julienp17/WaveMirror/arduino/README.md

The **waveMirror** directory contains the program used for the project.

The **examples** directory only contains parts of the code, to test standalone features (I2C, a Servo-motor, etc...).
