julienp17/WaveMirror/presentation/elements/pictures/fritzing/arduino_fritzing.png

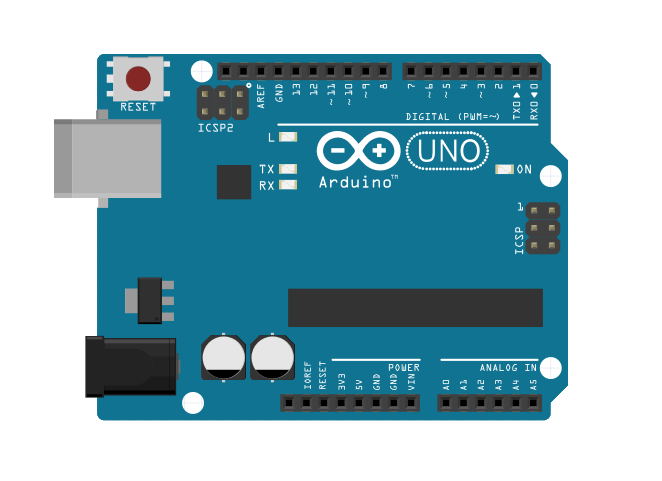
presentation/elements/pictures/fritzing/arduino_fritzing.png
