julienp17/WaveMirror/presentation/elements/pictures/hqdefault.jpg

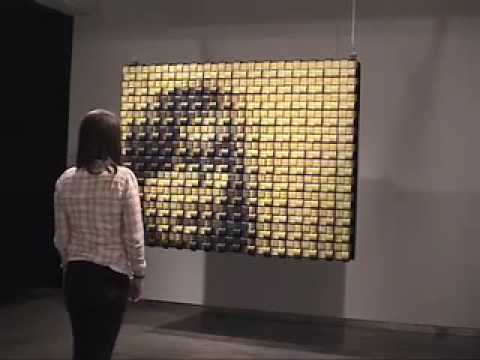
presentation/elements/pictures/hqdefault.jpg
