julienp17/WaveMirror/presentation/elements/pictures/weave-mirror.jpg

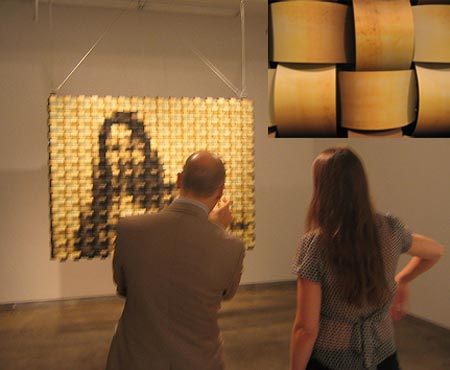
presentation/elements/pictures/weave-mirror.jpg
