julienp17/WaveMirror/presentation/elements/pictures/Weave-small_e.jpg

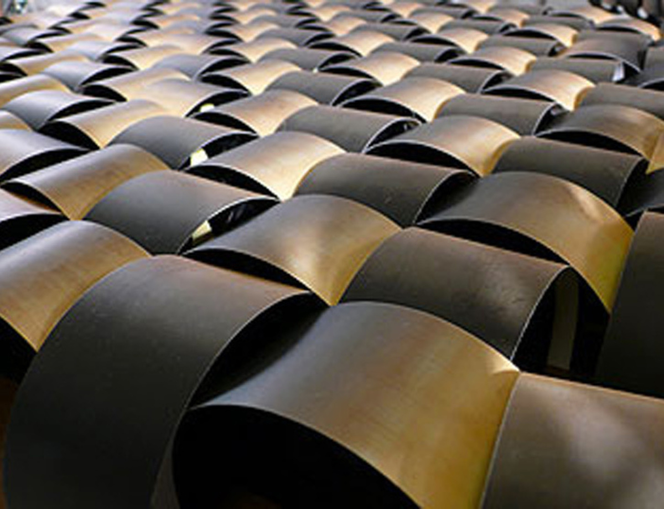
presentation/elements/pictures/Weave-small_e.jpg
