julienp17/WaveMirror/presentation/elements/pictures/weavemirror.jpg

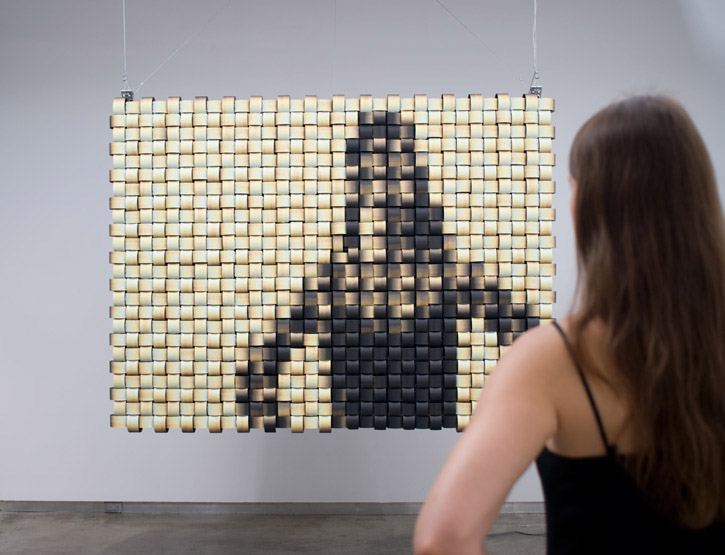
presentation/elements/pictures/weavemirror.jpg
