julienp17/WaveMirror/presentation/elements/pictures/weavemirrormov.jpg

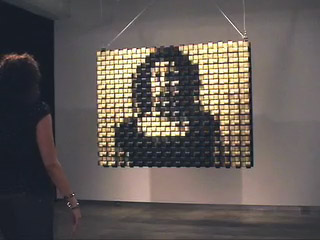
presentation/elements/pictures/weavemirrormov.jpg
