julienp17/WaveMirror/presentation/elements/raspberry_pi/colonne_X.png

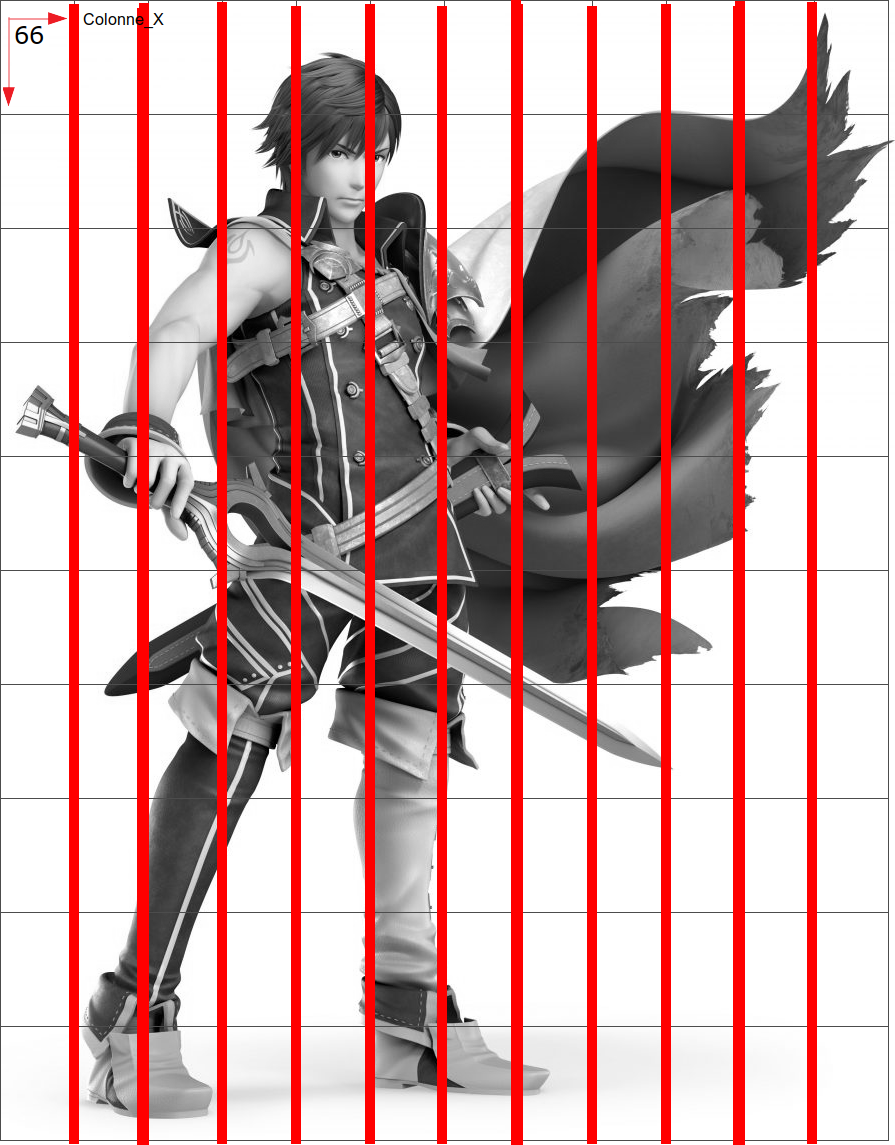
presentation/elements/raspberry_pi/colonne_X.png
