julienp17/WaveMirror/presentation/elements/raspberry_pi/first_line.png

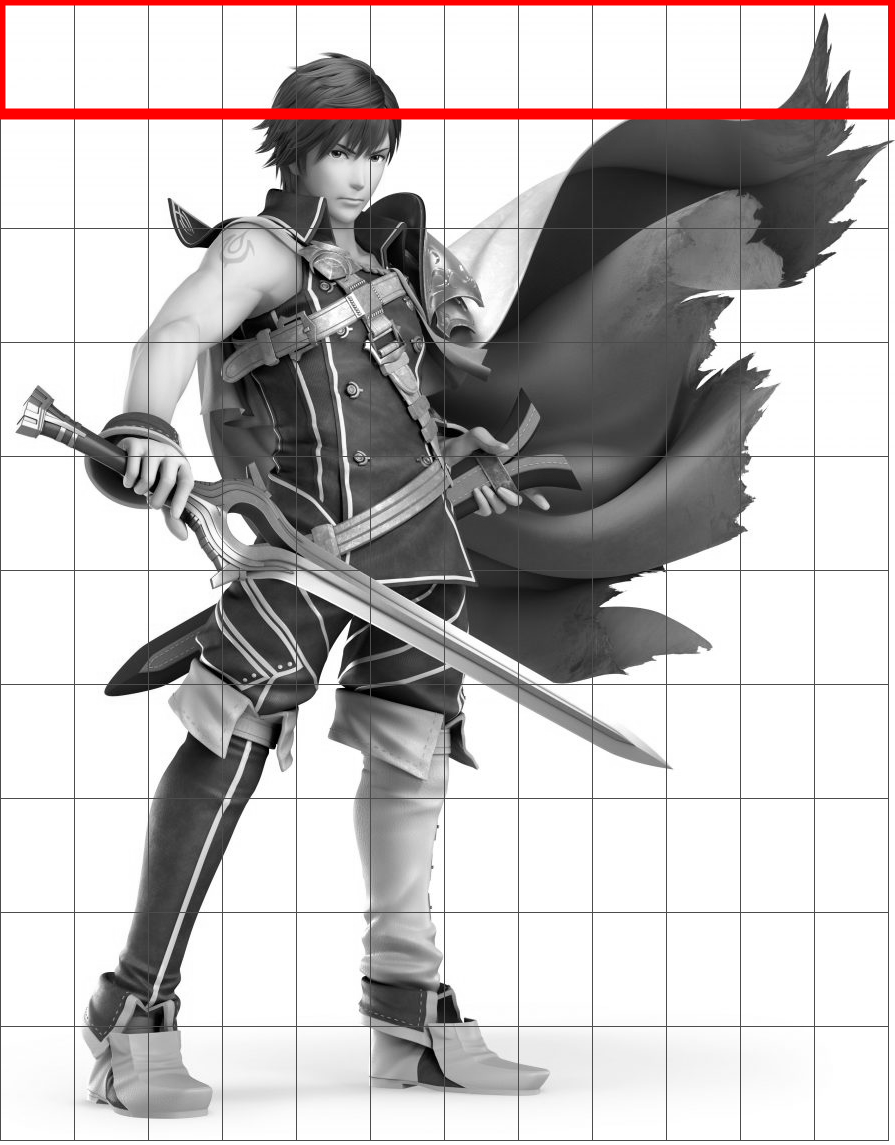
presentation/elements/raspberry_pi/first_line.png
