julienp17/WaveMirror/presentation/elements/raspberry_pi/picamera.png

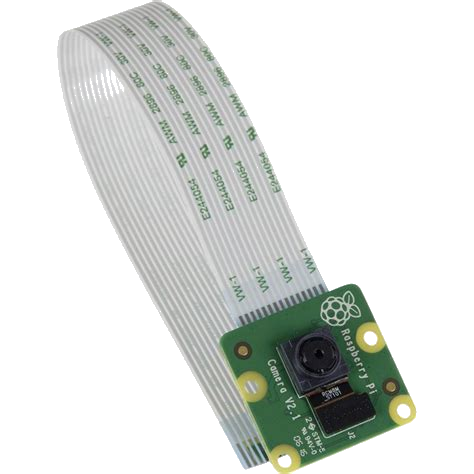
presentation/elements/raspberry_pi/picamera.png
