julienp17/WaveMirror/presentation/elements/raspberry_pi/pixel.png

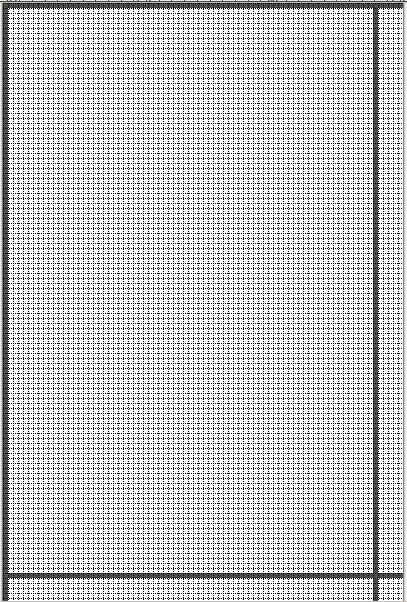
presentation/elements/raspberry_pi/pixel.png
