julienp17/WaveMirror/presentation/elements/raspberry_pi/pixel_dimensions.png

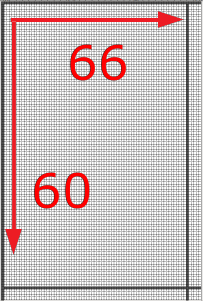
presentation/elements/raspberry_pi/pixel_dimensions.png
