julienp17/WaveMirror/presentation/elements/raspberry_pi/raspberryPi.png

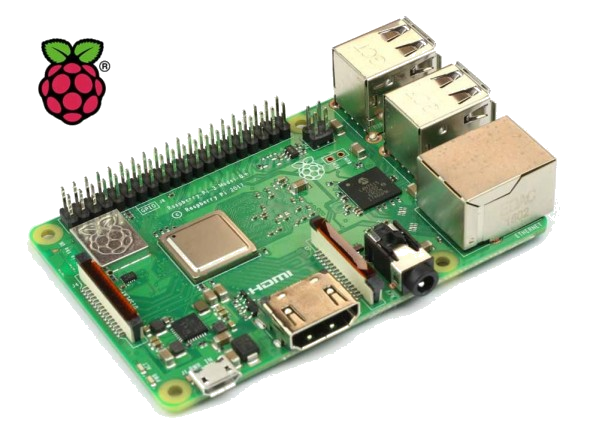
presentation/elements/raspberry_pi/raspberryPi.png
