julienp17/WaveMirror/presentation/elements/raspberry_pi/raspbian.png

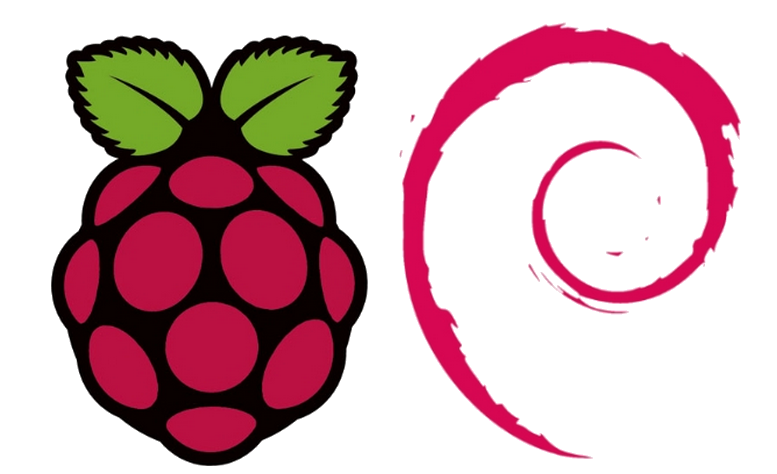
presentation/elements/raspberry_pi/raspbian.png
