julienp17/WaveMirror/presentation/elements/raspberry_pi/smiley2.png

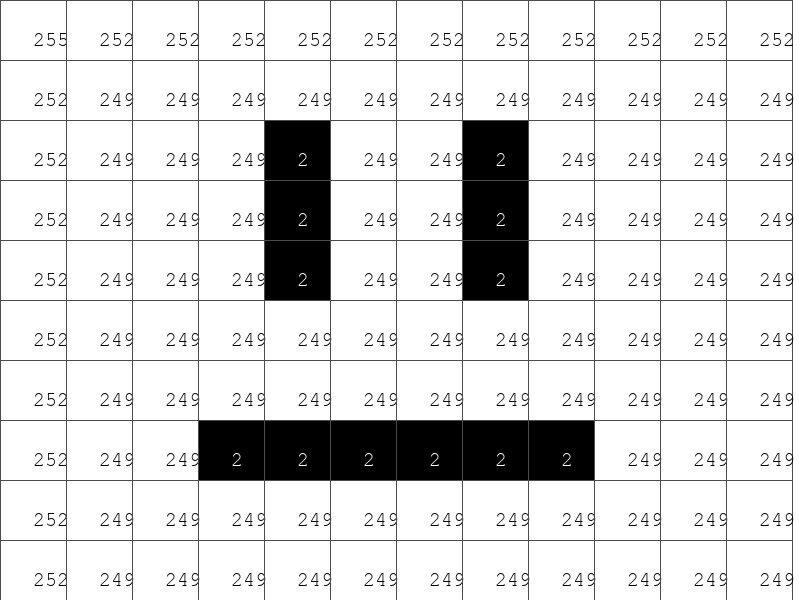
presentation/elements/raspberry_pi/smiley2.png
