julienp17/WaveMirror/presentation/elements/raspberry_pi/smiley3.png

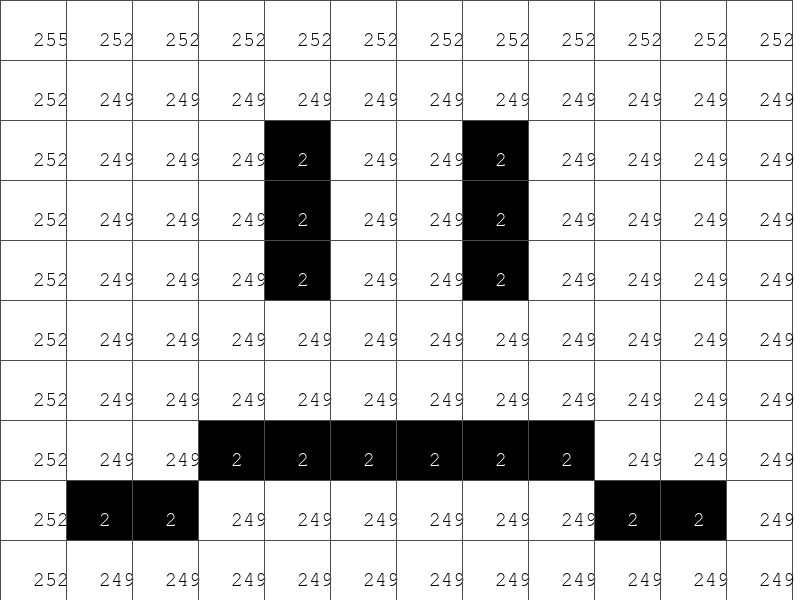
presentation/elements/raspberry_pi/smiley3.png
