julienp17/WaveMirror/raspberry_pi/examples/pictures/chrom.png

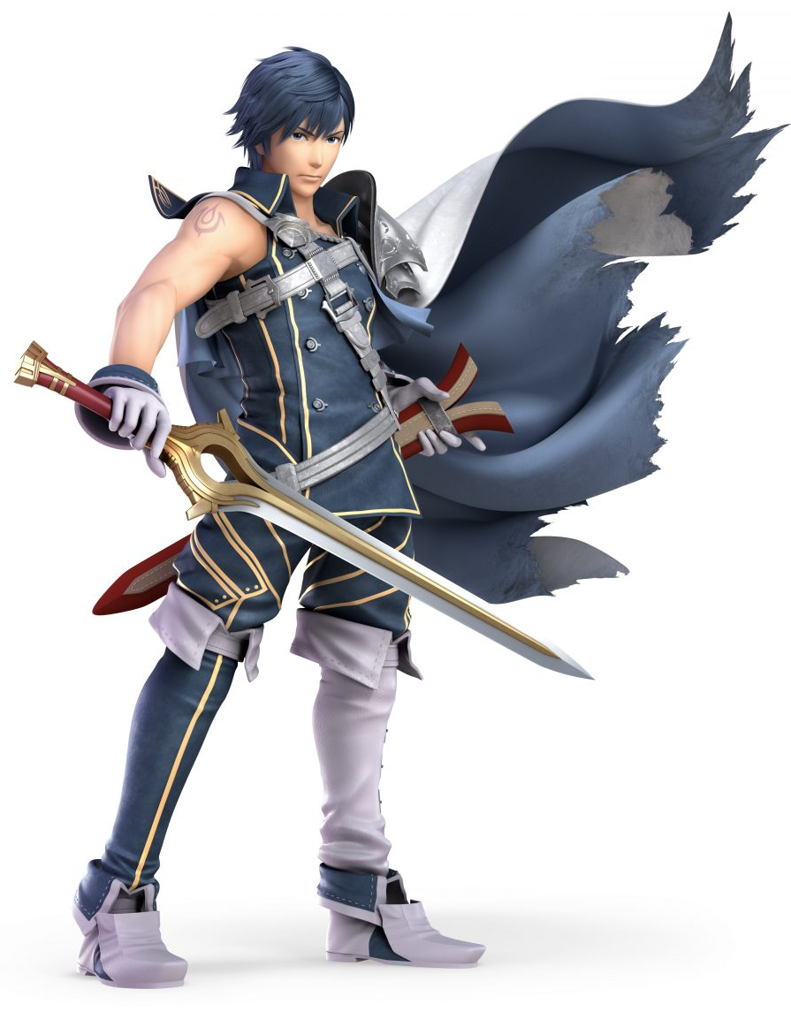
raspberry_pi/examples/pictures/chrom.png
