julienp17/WaveMirror/raspberry_pi/examples/pictures/grid.png

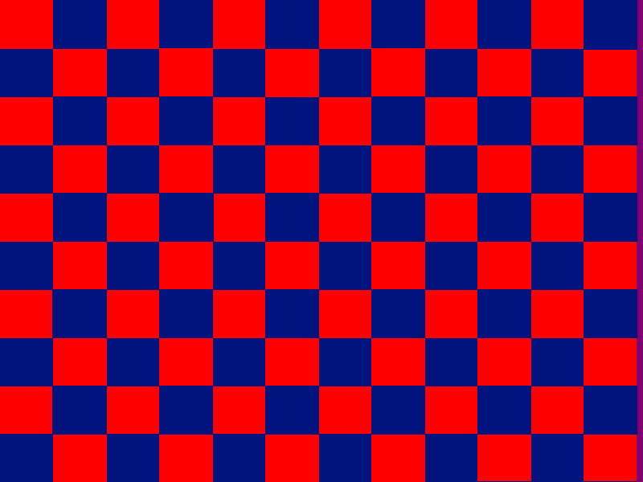
raspberry_pi/examples/pictures/grid.png
