julienp17/WaveMirror/raspberry_pi/examples/pictures/O.png

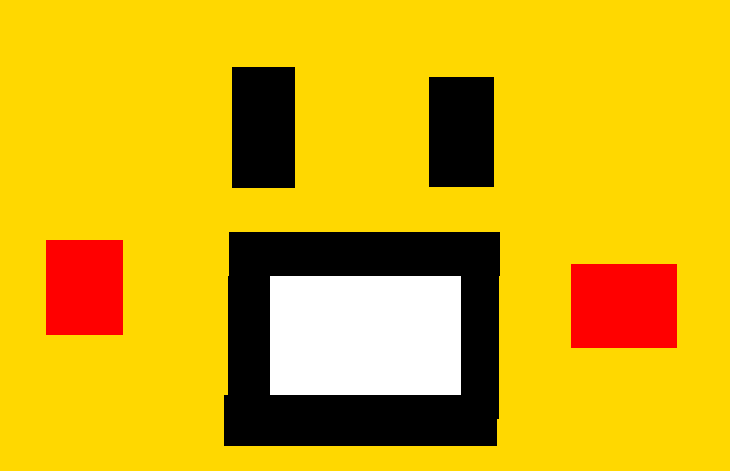
raspberry_pi/examples/pictures/O.png
