julienp17/WaveMirror/raspberry_pi/examples/pictures/smileyHappy.png

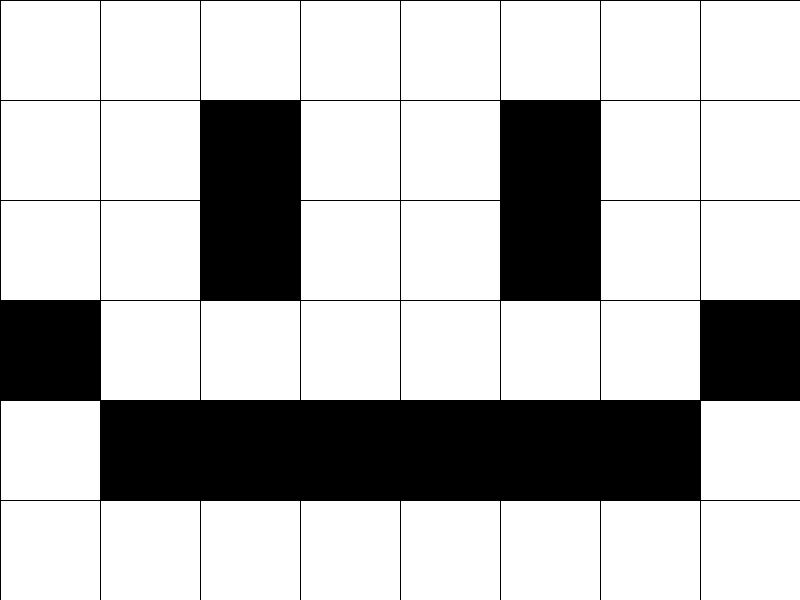
raspberry_pi/examples/pictures/smileyHappy.png
