julienp17/WaveMirror/raspberry_pi/examples/pictures/smileyNeutral.png

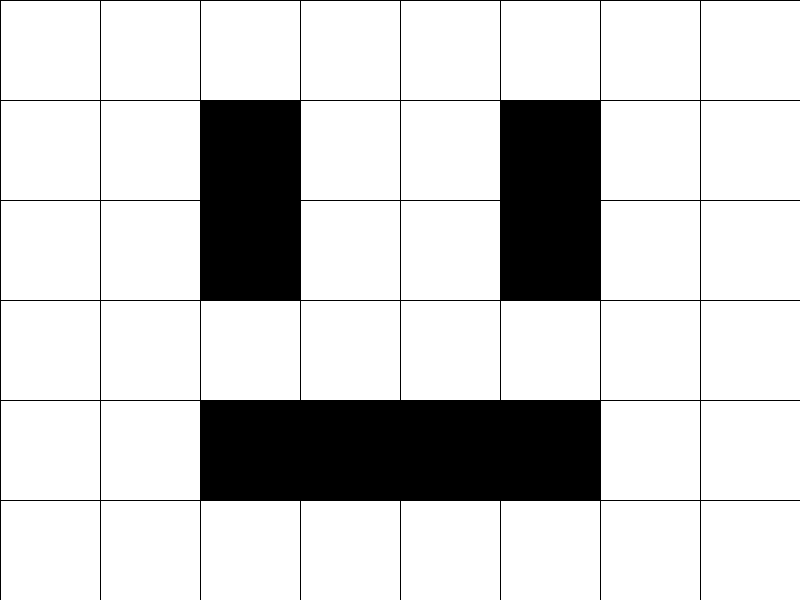
raspberry_pi/examples/pictures/smileyNeutral.png
