julienp17/WaveMirror/raspberry_pi/examples/pictures/smileySad.png

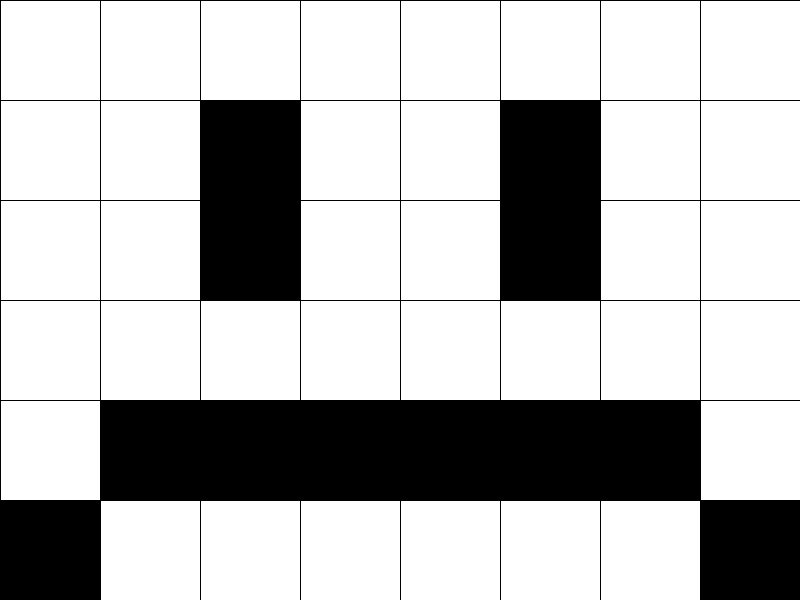
raspberry_pi/examples/pictures/smileySad.png
