julienp17/WaveMirror/solidworks/pieces/mini-servo-9g/Renderings/Mini_servo.JPG

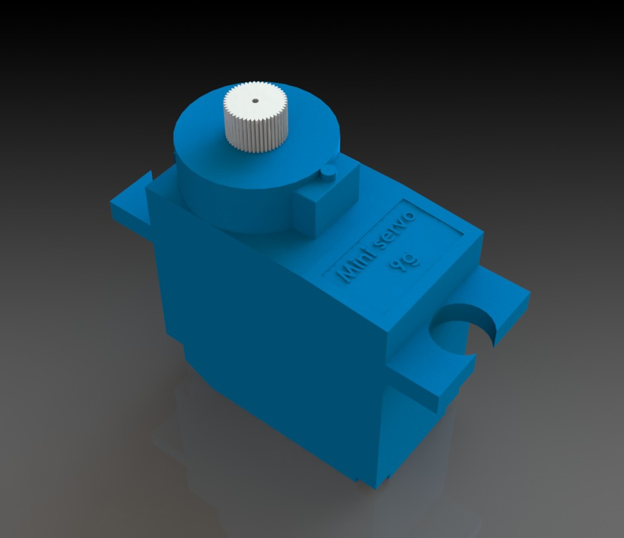
solidworks/pieces/mini-servo-9g/Renderings/Mini_servo.JPG
