julienp17/WaveMirror/solidworks/pieces/servo hs-55/Servo Hitec HS-55 .png

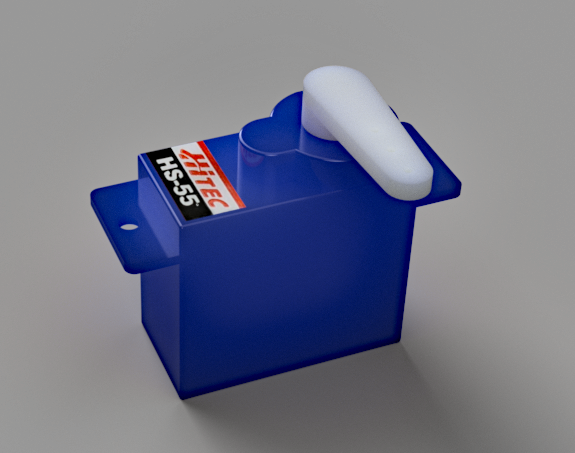
solidworks/pieces/servo hs-55/Servo Hitec HS-55 .png
