julienp17/WaveMirror/solidworks/assemblages/Assemblage3_20190204.SLDASM

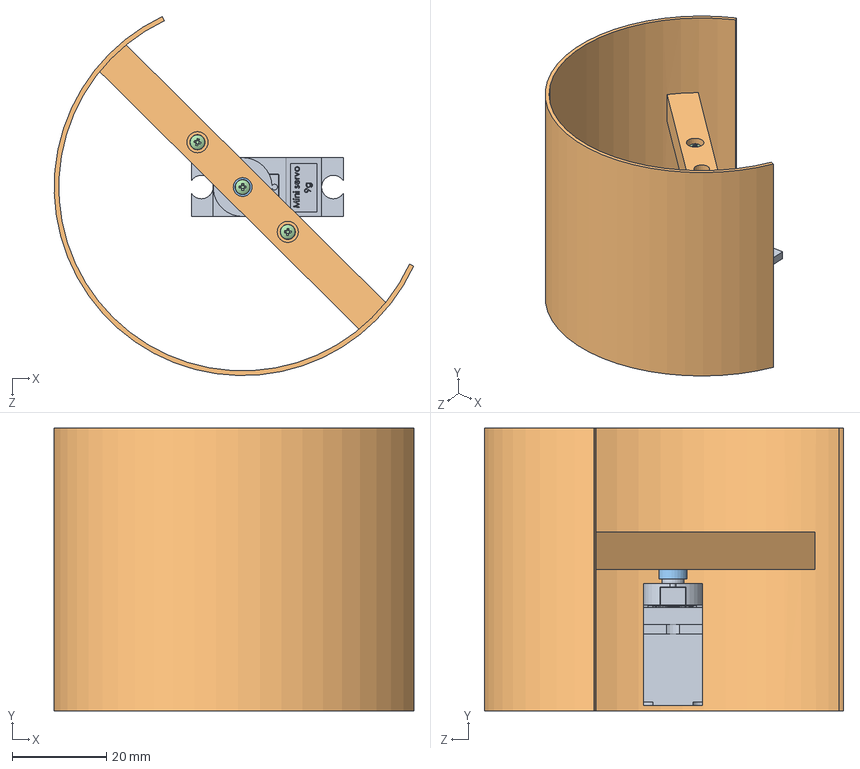
[picture p64: CAD file, 2019-03-29]
solidworks/assemblages/Assemblage3_20190204.SLDASM
76.3 x 60.0 x 76.2 mm
MiniServo
Cylindre4_20181203
palemoteur_20181029
pan head cross recess screw_isa x 3
