julienp17/WaveMirror/solidworks/pieces/mini-servo-9g/servomoteurhs-55_20181105.SLDASM

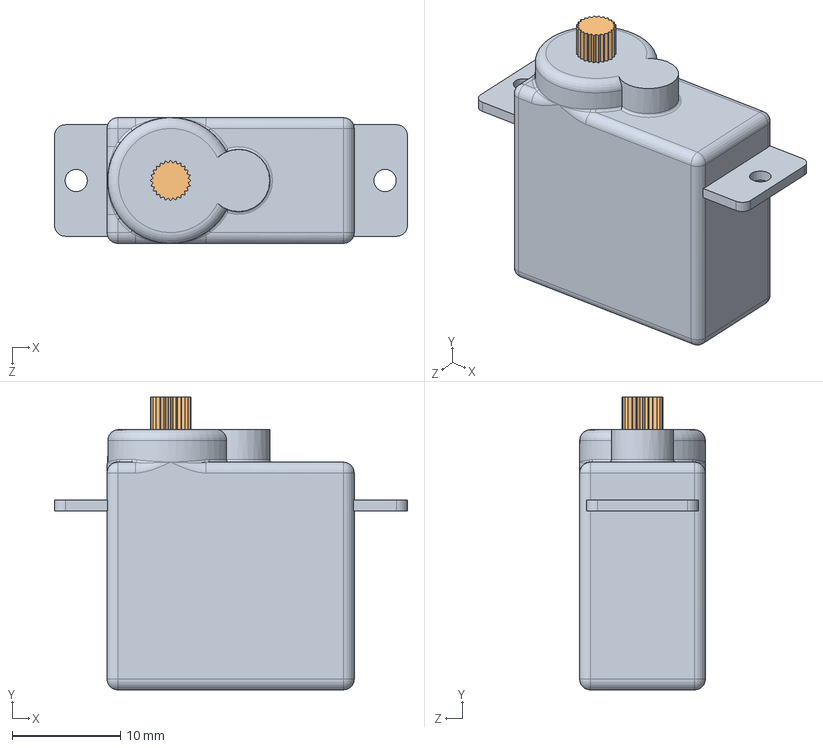
[picture p65: CAD file, 2018-11-21]
solidworks/pieces/mini-servo-9g/servomoteurhs-55_20181105.SLDASM
32.5 x 27.0 x 11.6 mm
Hi-Tec_HS-55_Bodyvrai
Hi-Tec_HS-55_Shaft
