julienp17/WaveMirror/solidworks/prototypes/Equipagemobile/Piece_entiere_20190215.SLDASM

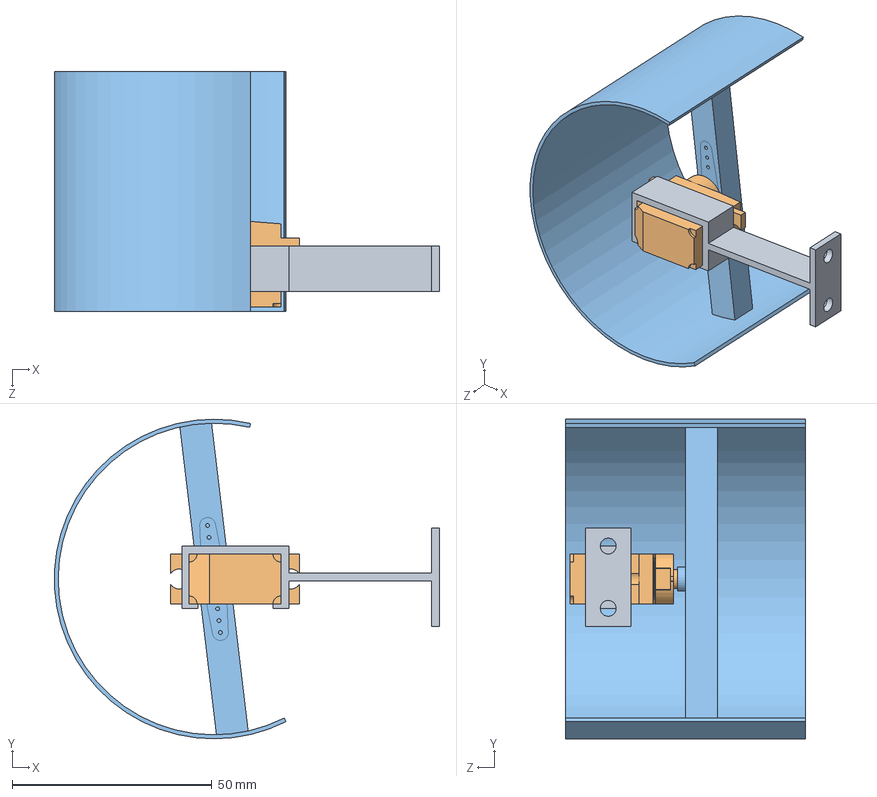
[picture p66: CAD file, 2019-03-29]
solidworks/prototypes/Equipagemobile/Piece_entiere_20190215.SLDASM
96.4 x 80.0 x 60.0 mm
supportmoteur2_20181210
MiniServo
Equipagemobile2_20190204
