julienp17/WaveMirror/solidworks/assemblages/Assemblage1_20180924.SLDASM

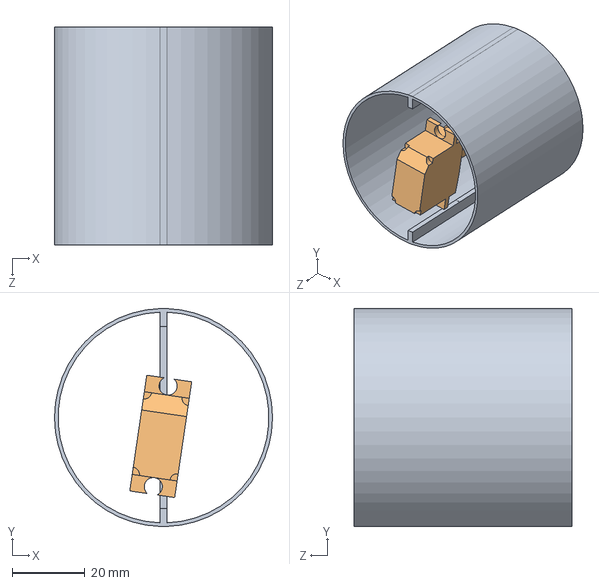
[picture p67: CAD file, 2018-11-21]
solidworks/assemblages/Assemblage1_20180924.SLDASM
60.0 x 60.0 x 60.0 mm
Prototype1_20180924
MiniServo
