julienp17/WaveMirror/solidworks/prototypes/Equipagemobile/Equipage_mobile3_20190211.SLDASM

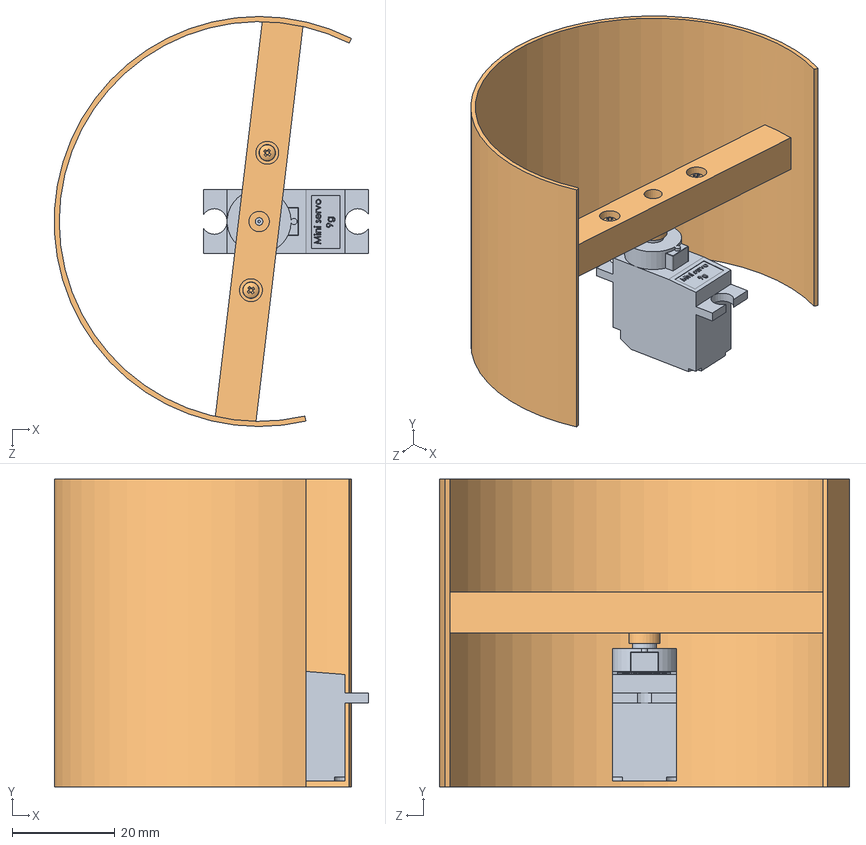
[picture p68: CAD file, 2019-03-29]
solidworks/prototypes/Equipagemobile/Equipage_mobile3_20190211.SLDASM
61.3 x 60.0 x 80.0 mm
MiniServo
Equipagemobile2_20190204
