julienp17/WaveMirror/solidworks/pieces/Cylindre_meca_3d_20190128.SLDASM

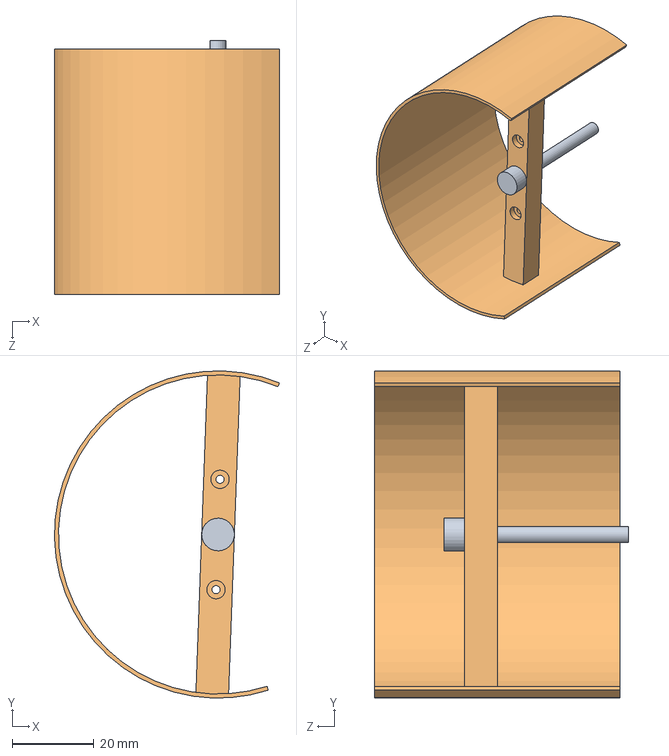
[picture p69: CAD file, 2019-03-29]
solidworks/pieces/Cylindre_meca_3d_20190128.SLDASM
55.0 x 79.9 x 62.0 mm
Pièce-pour_meca_3d
Cylindre4_20181203
