julienp17/WaveMirror/solidworks/pieces/palemoteur_20181029.SLDPRT

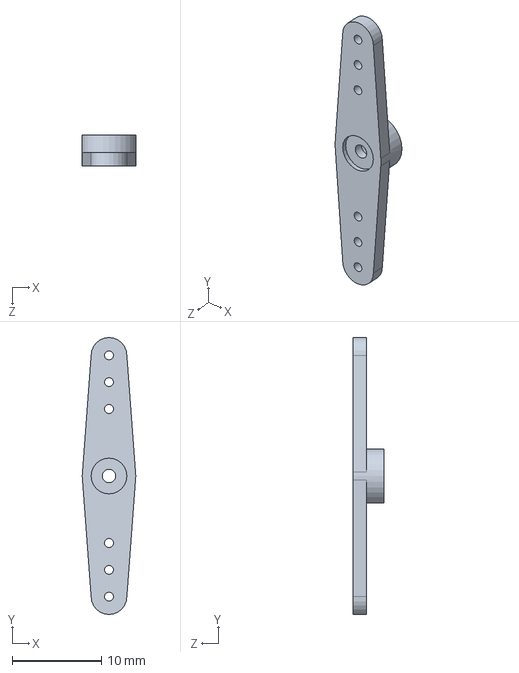
[picture p70: CAD file, 2019-03-29]
solidworks/pieces/palemoteur_20181029.SLDPRT
6.00 x 31.0 x 3.50 mm
