julienp17/WaveMirror/solidworks/prototypes/cylindres/Equipagemobile_20190204.SLDPRT

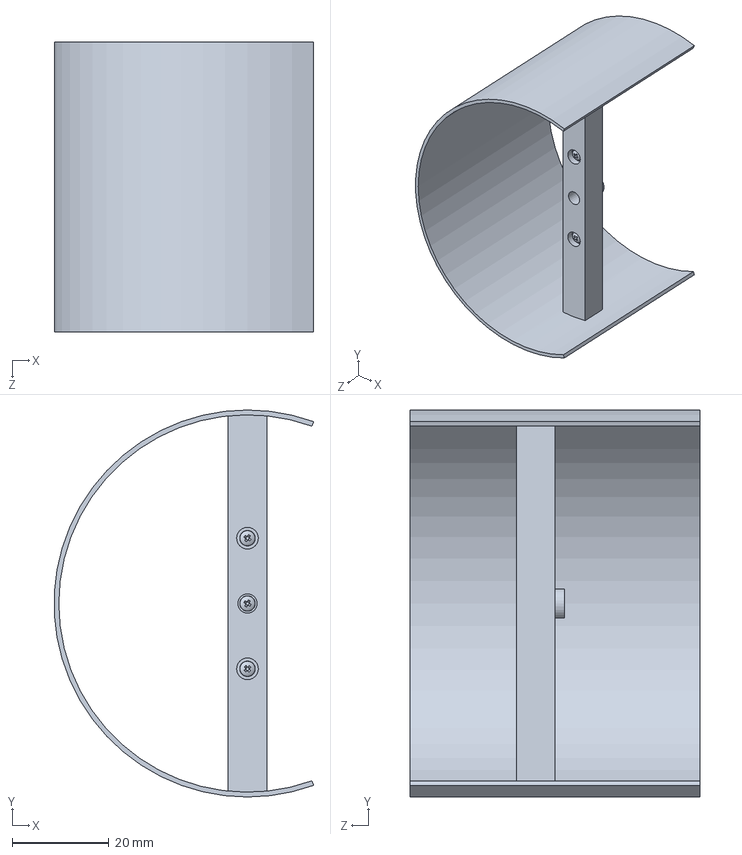
[picture p71: CAD file, 2019-03-29]
solidworks/prototypes/cylindres/Equipagemobile_20190204.SLDPRT
53.6 x 80.0 x 60.0 mm
