julienp17/WaveMirror/solidworks/prototypes/support_moteur/supportmoteur2_20181210.SLDPRT

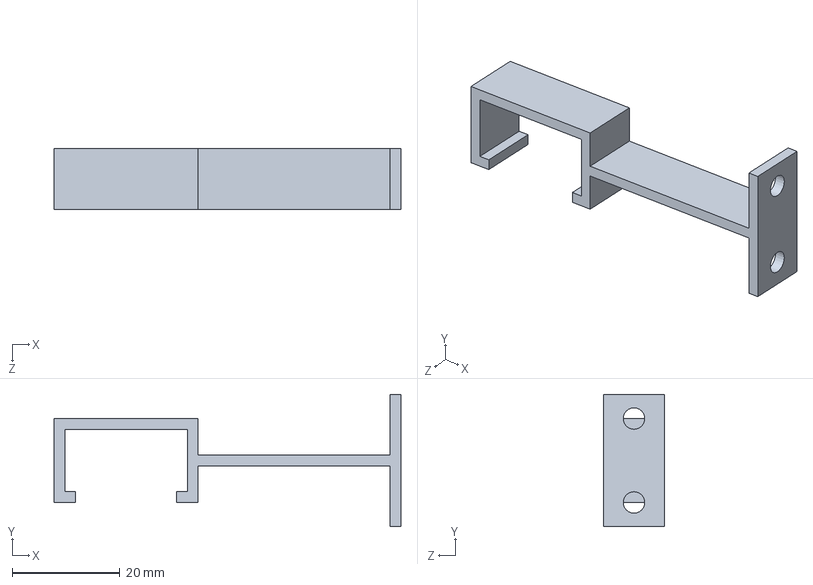
[picture p72: CAD file, 2019-03-29]
solidworks/prototypes/support_moteur/supportmoteur2_20181210.SLDPRT
64.5 x 24.6 x 11.3 mm
