julienp17/WaveMirror/solidworks/pieces/mini-servo-9g/MiniServo.SLDPRT

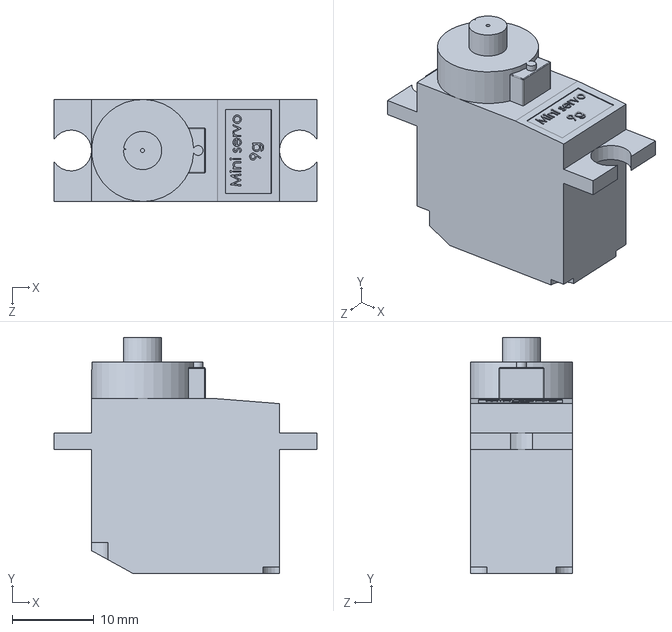
[picture p73: CAD file, 2018-11-21]
solidworks/pieces/mini-servo-9g/MiniServo.SLDPRT
32.2 x 28.9 x 12.5 mm
