julienp17/WaveMirror/solidworks/pieces/Piece-pour_meca_3d.SLDPRT

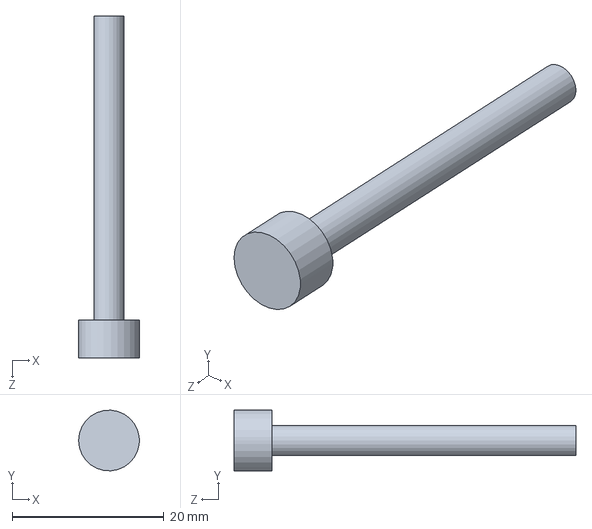
[picture p74: CAD file, 2019-03-29]
solidworks/pieces/Piece-pour_meca_3d.SLDPRT
8.00 x 7.99 x 45.0 mm
