julienp17/WaveMirror/solidworks/prototypes/support_moteur/supportmoteur1_20181210.SLDPRT

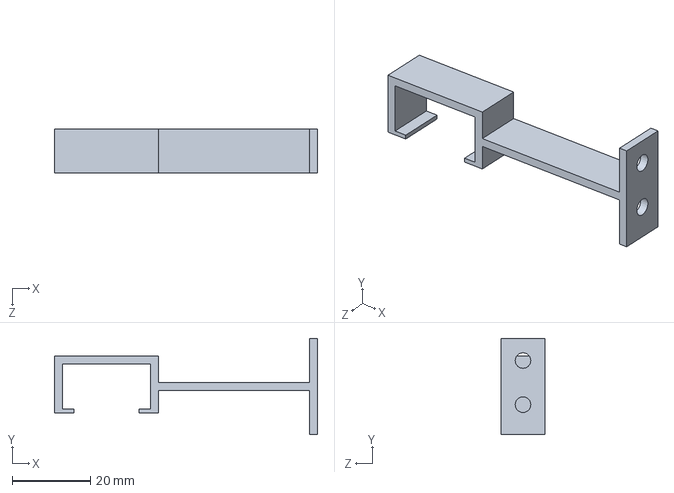
[picture p75: CAD file, 2018-12-14]
solidworks/prototypes/support_moteur/supportmoteur1_20181210.SLDPRT
67.3 x 24.6 x 11.3 mm
