julienp17/WaveMirror/solidworks/prototypes/cylindres/Cylindre4_20181203.SLDPRT

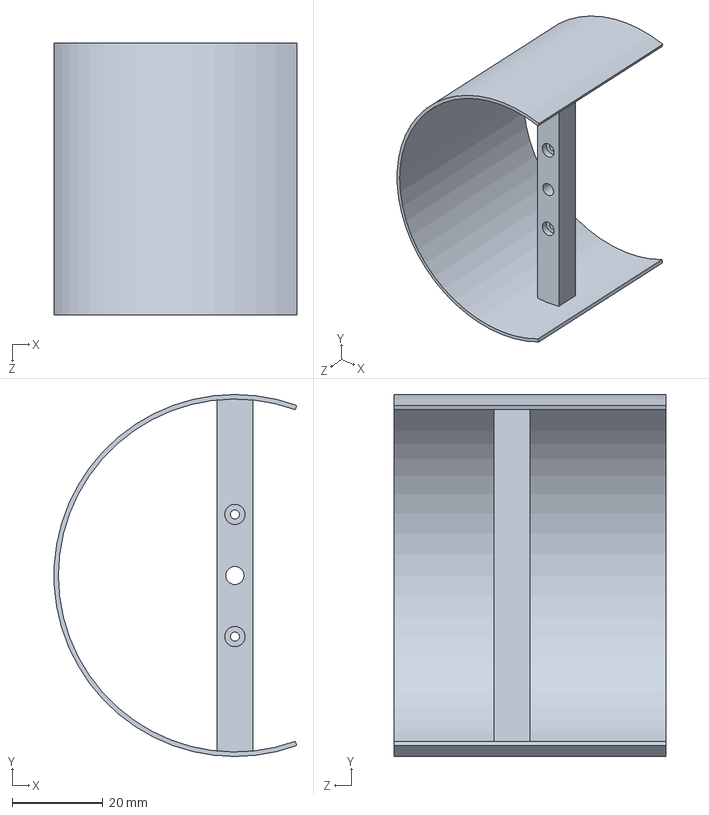
[picture p76: CAD file, 2019-03-29]
solidworks/prototypes/cylindres/Cylindre4_20181203.SLDPRT
53.6 x 80.0 x 60.0 mm
