julienp17/WaveMirror/solidworks/prototypes/support_moteur/supportmoteur1_20181203.SLDPRT

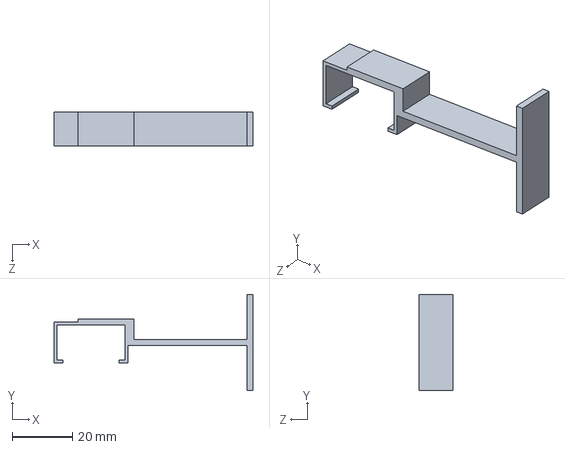
[picture p77: CAD file, 2018-12-14]
solidworks/prototypes/support_moteur/supportmoteur1_20181203.SLDPRT
66.3 x 32.0 x 11.3 mm
