julienp17/WaveMirror/solidworks/pieces/supportmoteur_20181008.SLDPRT

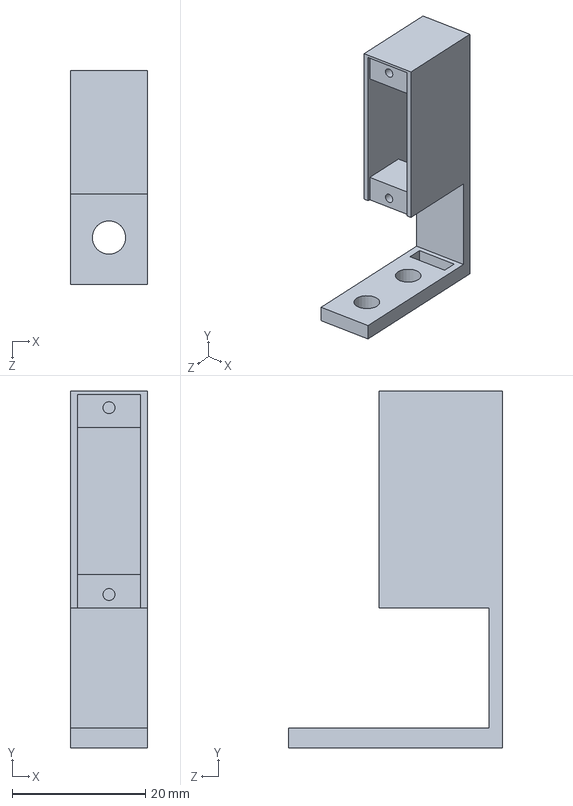
[picture p78: CAD file, 2018-11-21]
solidworks/pieces/supportmoteur_20181008.SLDPRT
11.5 x 53.5 x 32.0 mm
