julienp17/WaveMirror/solidworks/pieces/Cylindremoteursanspalme_20180917.SLDPRT

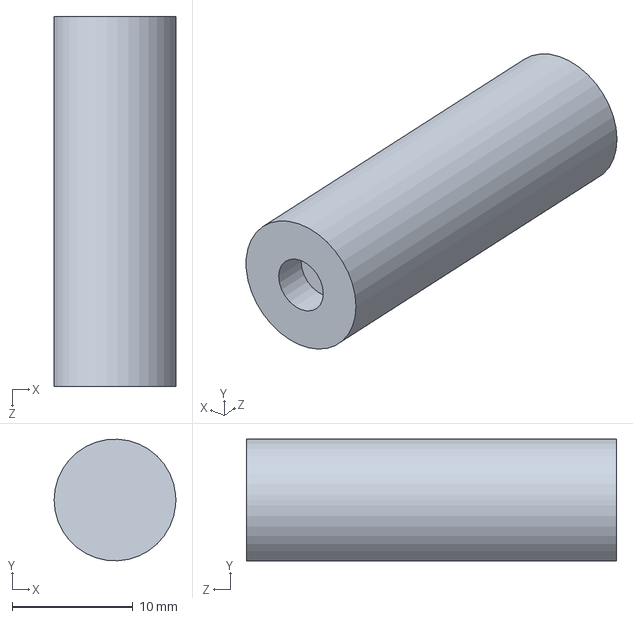
[picture p79: CAD file, 2018-11-21]
solidworks/pieces/Cylindremoteursanspalme_20180917.SLDPRT
10.1 x 10.1 x 30.7 mm
