julienp17/WaveMirror/solidworks/pieces/Servo-HS55.SLDPRT

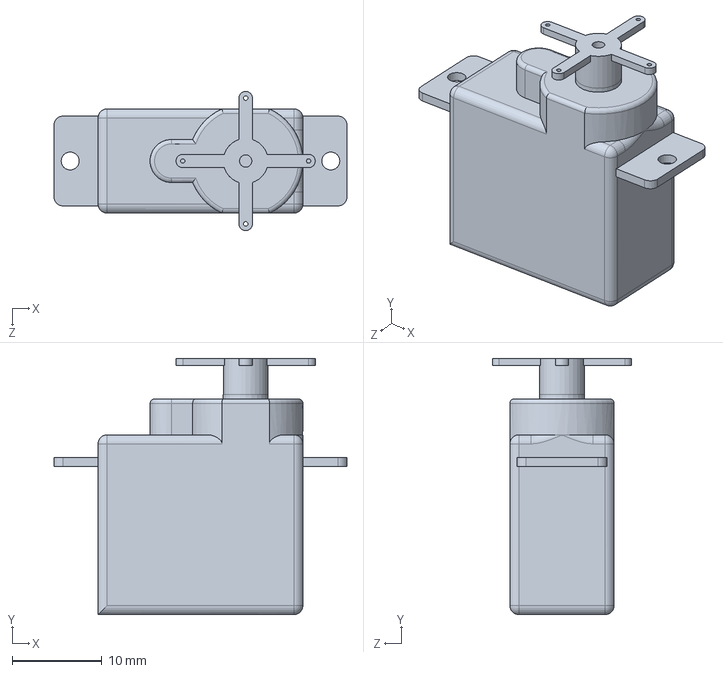
[picture p80: CAD file, 2018-11-21]
solidworks/pieces/Servo-HS55.SLDPRT
32.6 x 28.5 x 15.5 mm
