julienp17/WaveMirror/solidworks/prototypes/cylindres/Protoype2sanstrou_20181029.SLDPRT

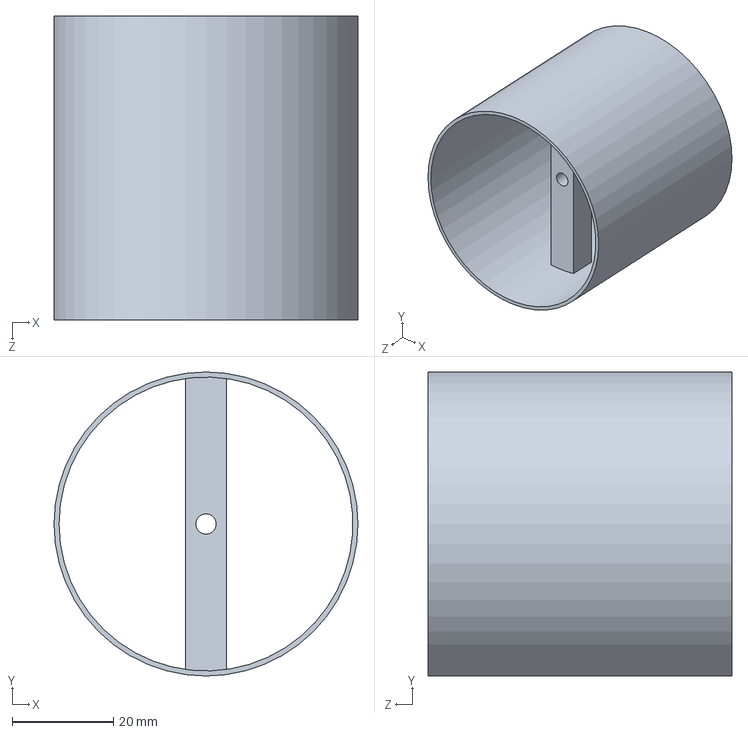
[picture p81: CAD file, 2018-11-21]
solidworks/prototypes/cylindres/Protoype2sanstrou_20181029.SLDPRT
60.0 x 60.0 x 60.0 mm
