julienp17/WaveMirror/solidworks/prototypes/cylindres/Prototype1_20181029.SLDPRT

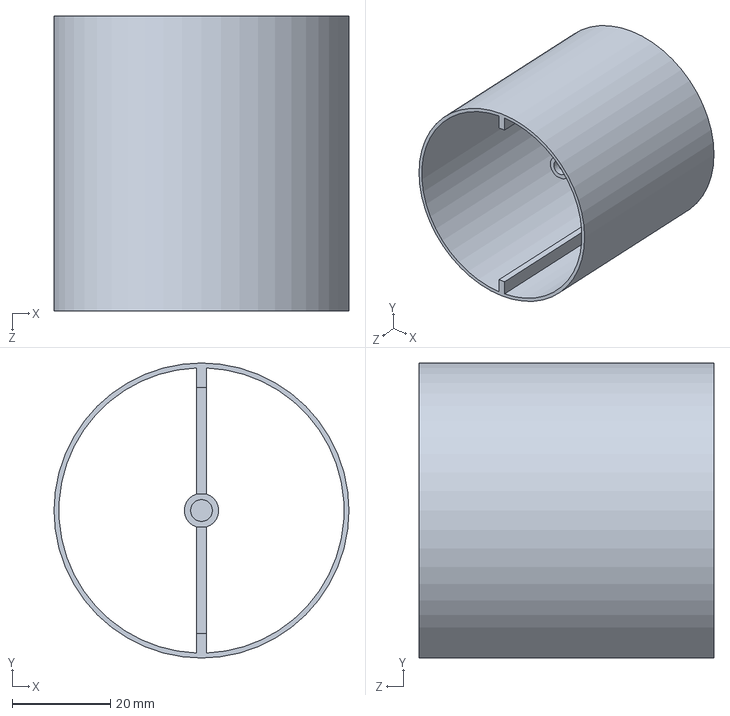
[picture p82: CAD file, 2018-11-21]
solidworks/prototypes/cylindres/Prototype1_20181029.SLDPRT
60.0 x 60.0 x 60.0 mm
