julienp17/WaveMirror/solidworks/prototypes/cylindres/Protoype3_20181112.SLDPRT

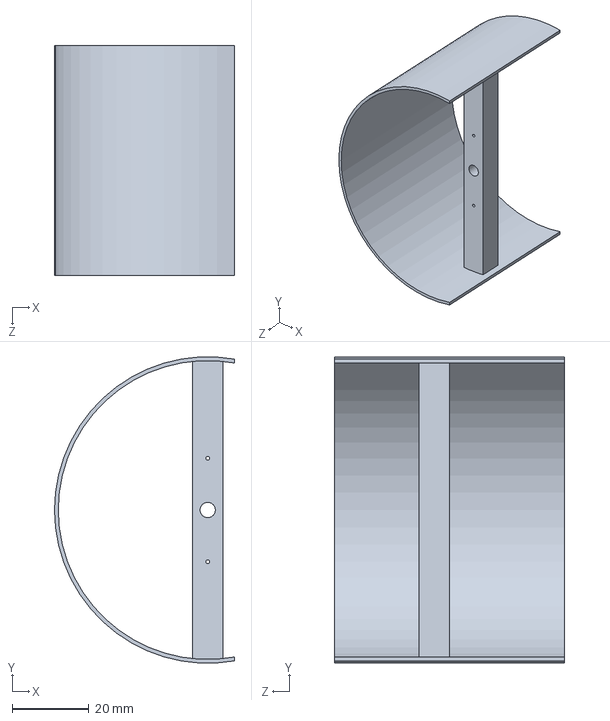
[picture p83: CAD file, 2018-11-21]
solidworks/prototypes/cylindres/Protoype3_20181112.SLDPRT
47.0 x 79.9 x 60.0 mm
