julienp17/WaveMirror/(list of files, cad)

Other CAD files:
solidworks/pieces/servo/servo.SLDASM
solidworks/assemblages/Assemblage2_20181105.SLDASM
solidworks/pieces/servo hs-55/Servo Hitec HS-55.SLDPRT
solidworks/prototypes/Plan/Plan_20190325.SLDPRT
solidworks/pieces/servo/servo cover.SLDPRT
solidworks/prototypes/cylindres/Equipagemobile2_20190204.SLDPRT
solidworks/pieces/servo/spline output.SLDPRT
solidworks/pieces/servo/servo Case.SLDPRT
solidworks/prototypes/cylindres/Protoype4_20181203.STL
solidworks/prototypes/cylindres/Protoype3_20181130.SLDPRT
solidworks/pieces/servo/bottom cover.SLDPRT
solidworks/prototypes/cylindres/Protoype2_20181029.SLDPRT
solidworks/prototypes/cylindres/Prototype1_20180924.SLDPRT
solidworks/prototypes/cylindres/Protoype2_20181105.SLDPRT
solidworks/pieces/mini-servo-9g/MiniServo.STL
solidworks/pieces/servo/long screw.SLDPRT
solidworks/prototypes/cylindres/Cylindre4_20181203.STL
solidworks/prototypes/cylindres/Prototype1_20181029(1).SLDPRT
solidworks/prototypes/cylindres/Protoype2sanstrou_20181029.STL
solidworks/prototypes/cylindres/Protoype3_20181130.STL
solidworks/prototypes/support_moteur/supportmoteur1_20181210.STL
solidworks/prototypes/support_moteur/supportmoteur2_20181210.STL
