julienp17/WaveMirror/presentation/elements/raspberry_pi/step5.png

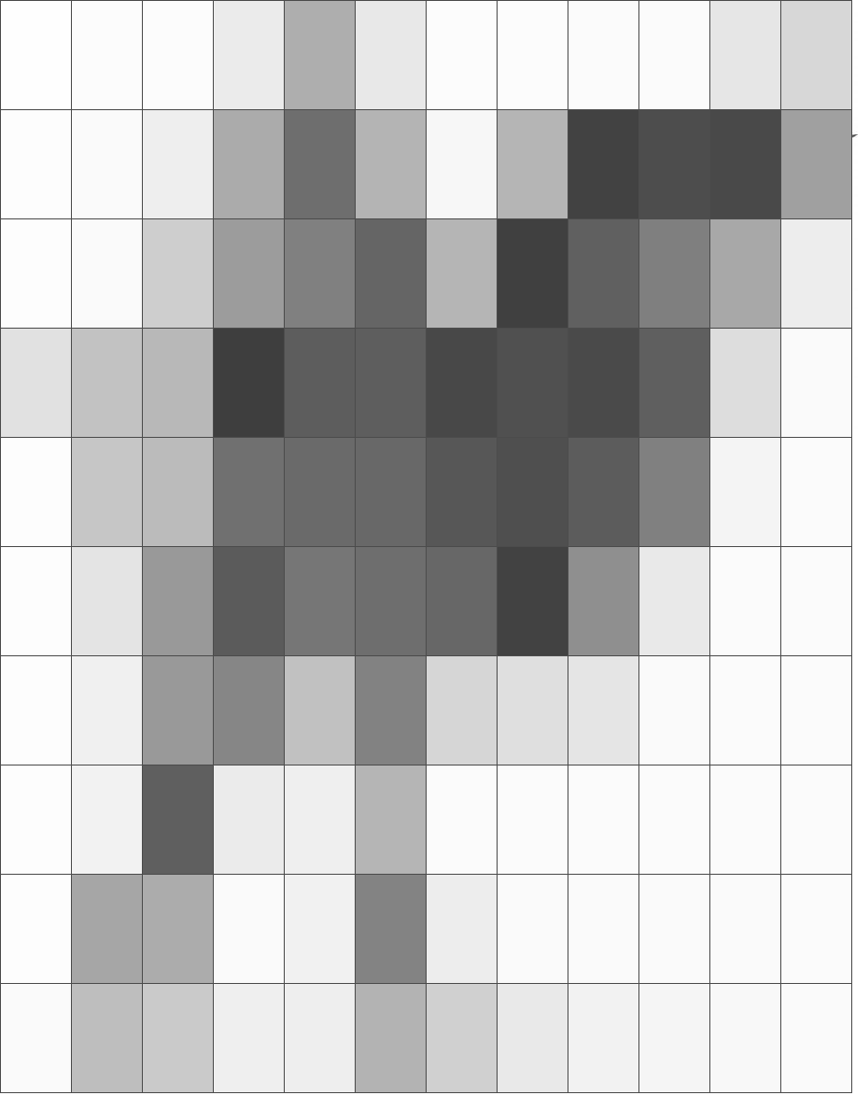
presentation/elements/raspberry_pi/step5.png
