julienp17/WaveMirror/(list of files, drawings)

Other design files:
global_schematics.fzz
presentation/elements/pictures/fritzing/sketch.fzz
