julienp17/WaveMirror/(commit log)

2018-11-21 Add some more files
    [Assemblage1.SLDASM, Assemblage1_20180924.SLDASM, Assemblage2_20181105.SLDASM, Cylindremoteursanspalme_20180917.SLDPRT, MiniServo.SLDPRT, MiniServo.STL, Prototype1_20180924.SLDPRT, Prototype1_20181029(1).SLDPRT]
2018-12-14 Backup (old files)
    [Assemblage1.SLDASM, Assemblage1_20180924.SLDASM, Cylindre4_20181203.SLDPRT, Cylindremoteursanspalme_20180917.SLDPRT, MiniServo.SLDPRT, MiniServo.STL, Planning 20180917.ods, Planning 20180924.ods]
2018-12-15 Update Raspberry's Pi README
2019-01-28 Made some tests and changes on the solo Servo arduino programm
2019-02-01 Reverted I2C Arduino code to make it work again
    [smiley.py]
2019-02-01 Added comments in Arduino code
    [ficheTechnique_ServoMoteur.ods, mesureServo.ods, projet.pdsprj]
2019-02-01 Added comments for the Arduino I2C code example
2019-02-02 Added comments for the Arduino oneServo example code
2019-02-02 Restructure the Raspberry Pi directory
2019-02-03 Added comments for the whole Raspberry Pi's example directory
2019-02-03 Change README for the source directory & Raspberry Pi's directory
2019-02-03 Added comments for the main Raspberry Pi's python code
2019-02-04 First final working Arduino main code
2019-02-04 Created camera & picture program
2019-02-05 Corrected comments for the new Arduino main program
    [waveMirror.ino]
2019-02-22 Updated Raspberry Pi's presentation
2019-02-25 Made the global sketch of the project
    [sketch.fzz]
2019-03-04 Finish the Raspberry Pi's presentation and rename some directories and files
    [Cylindremoteursanspalme_20180917.SLDPRT, MiniServo.SLDPRT, MiniServo.STL, Servo Hitec HS-55.SLDPRT, Servo-HS55.SLDPRT, ficheTechnique_ServoMoteur.ods, fiche_technique.ods, gantt-modÃ¨le-art - Copie.ods]
2019-03-11 Change variables names in Raspberry Pi's main code
2019-03-25 Fixed typo in documentation
    [wave_mirror.py]
2019-03-25 Deleted useless 'servos' directory
2019-03-29 Update solidworks directory
    [Assemblage3_20190204.SLDASM, Cylindre4_20181203.SLDPRT, Cylindre4_20181203.STL, Cylindre_meca_3d_20190128.SLDASM, Cylindremoteursanspalme_20180917.SLDPRT, Equipage_mobile3_20190211.SLDASM, Equipagemobile2_20190204.SLDPRT, Equipagemobile_20190204.SLDPRT]
2019-03-29 Fix directory name conflict
    [Cylindre_meca_3d_20190128.SLDASM, Cylindremoteursanspalme_20180917.SLDPRT, MiniServo.SLDPRT, MiniServo.STL, Piece-pour_meca_3d.SLDPRT, Servo Hitec HS-55.SLDPRT, Servo-HS55.SLDPRT, bottom cover.SLDPRT]
2019-04-01 Restructure and update presentation directory
    [planning.ods, sketch.fzz]
2019-04-20 Comment the Serial prints to speed up programm
2019-04-20 Create new arduino main script
2019-04-20 Clean working one servo code
2019-04-20 Update one servo code entirely
2019-04-20 Update main Arduino code entirely
2019-04-20 Move raspberry pi presentation pictures to a different directory
2019-04-20 Add schematics from main REAME
2019-04-22 Move Raspberry Pi's main program
2019-04-26 Add delay after servo movement
2019-05-03 Shorten the camera preview script
    [camera_preview.py]
2019-09-04 Add a fritzing & picture file
    [global_schematics.fzz]
